LiuRuiQi/315MHz-ASK-Transmission-Circuit/(list of files, drawings)

Other design files:
ASK315.ms14
PCBUse.ms14
