LiuRuiQi/315MHz-ASK-Transmission-Circuit/(commit log)

2015-10-23 Initial Add
    [ASK315.ms14]
2015-10-25 Add circuit design
2015-10-28 Add info on R315, new design
    [ASK315.ms14]
2015-11-11 PSC files
    [PCBUse.ms14]
2015-12-10 add PCB
